hacker-fab/usb-pd-psu/README.md

# USB PD PSU
Inspired by the [PocketPD project](https://github.com/CentyLab/PocketPD).  
Adjustable DC power supply based on AVS/PPS USB PD protocols. 
Uses the TPS26750A USB PD controller to handle up to 240W.
