hacker-fab/usb-pd-psu/hardware/pd_psu.pdf

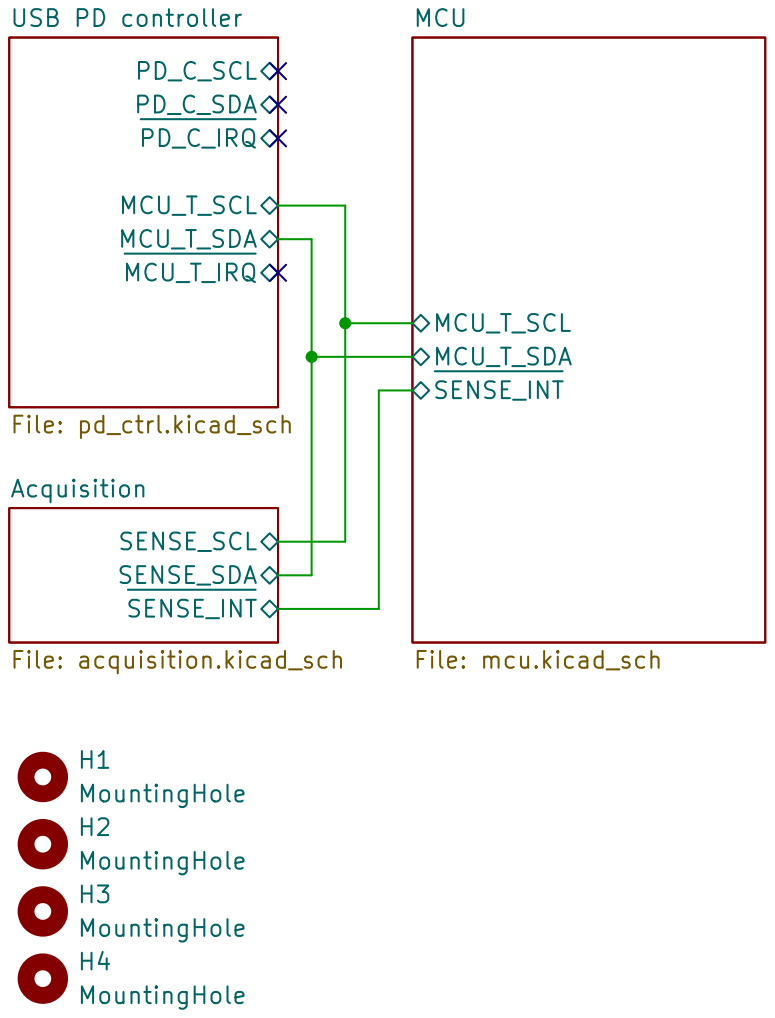
[picture p1: page 1]

Size: A4 | Rev:
KiCad E.D.A. 10.0.8 | Id: 1/4

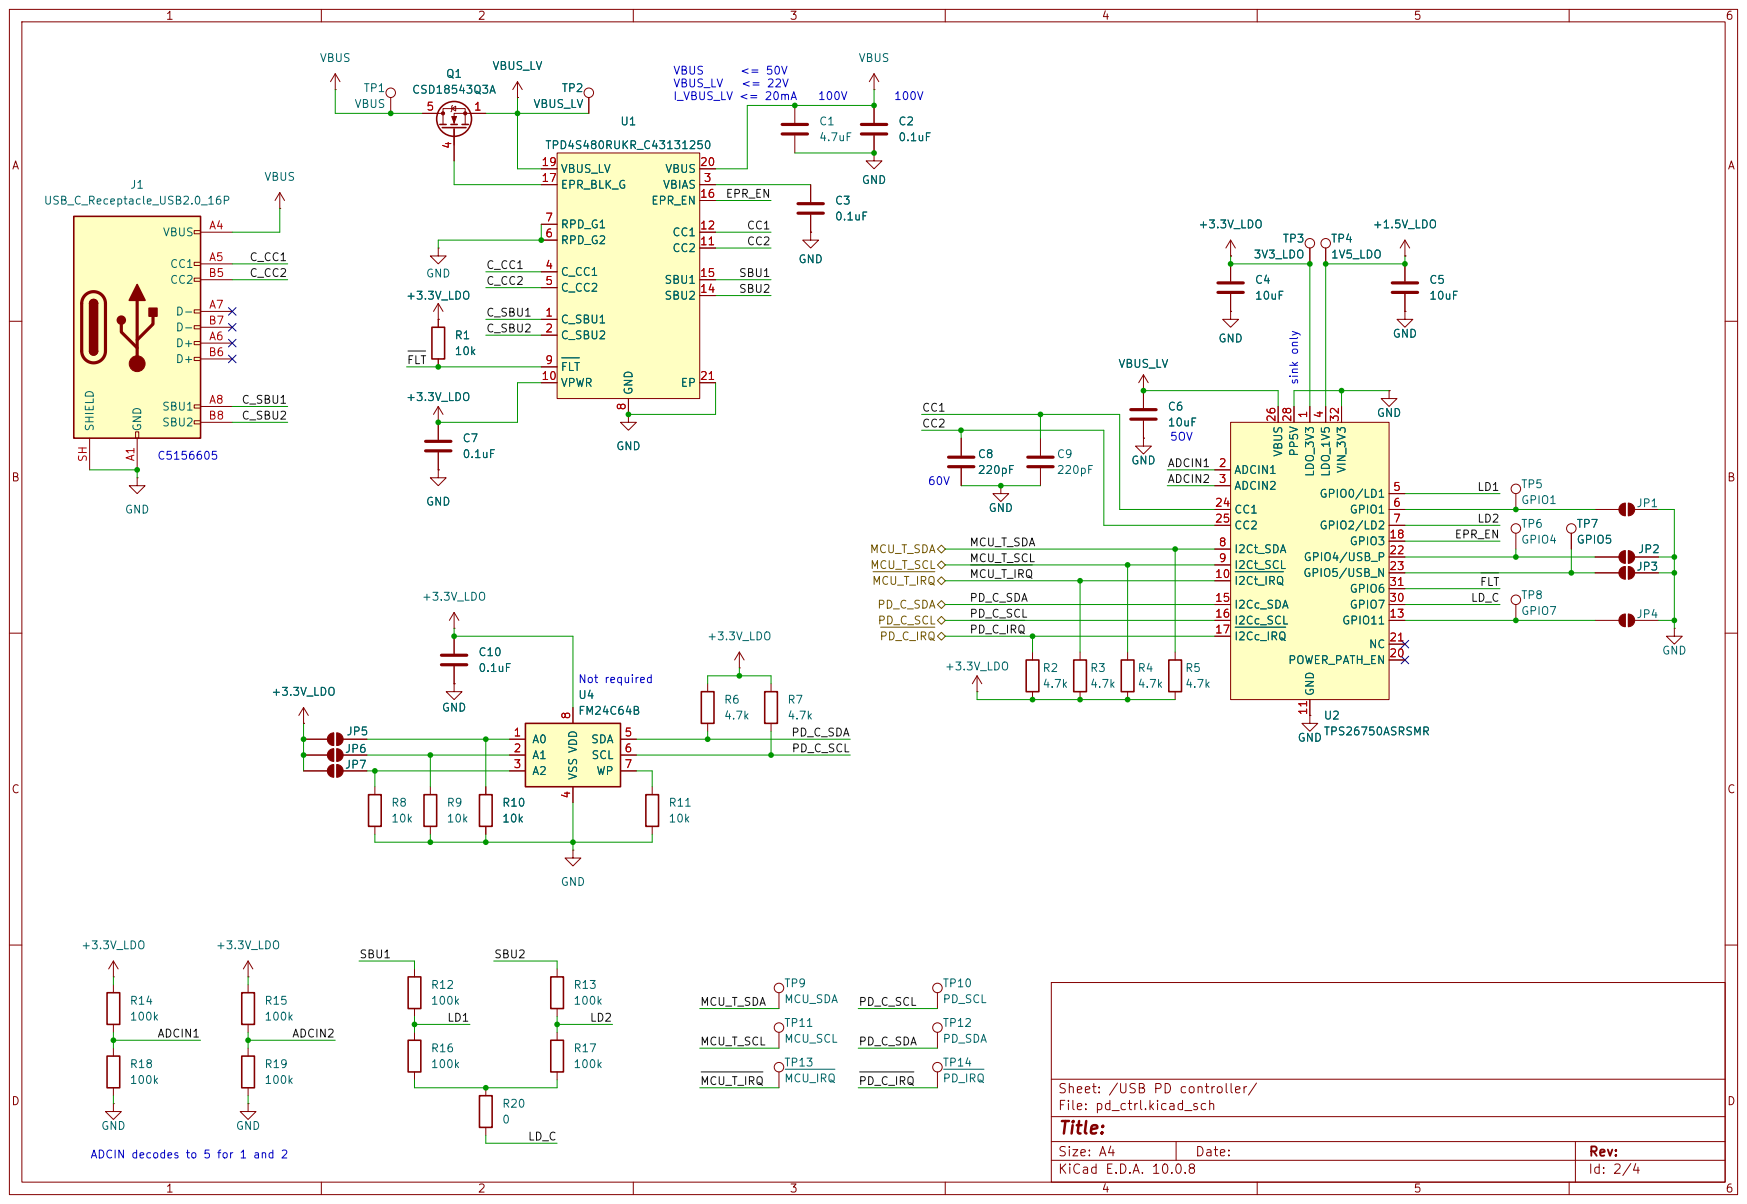
[picture p2: page 2]

I2Ct_SCL 9

Sheet: /USB PD controller/
File: pd_ctrl.kicad_sch
Title:

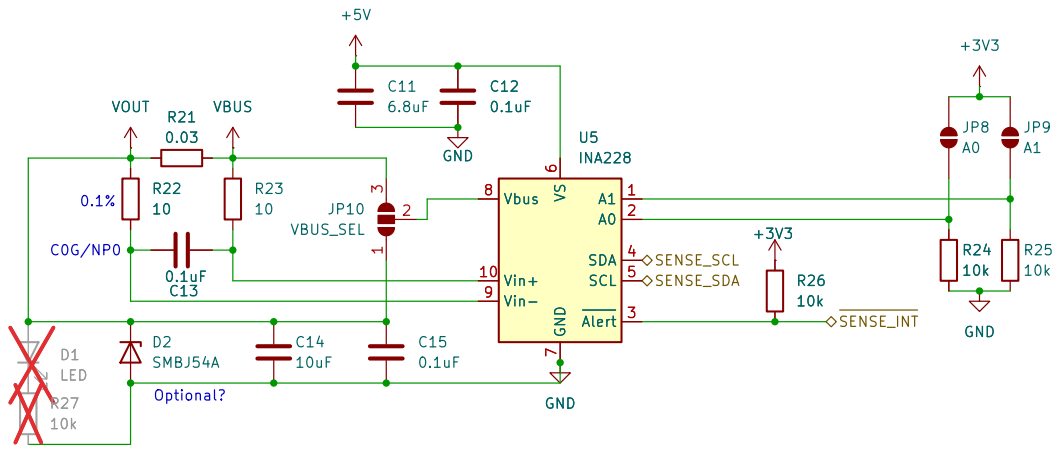
[picture p3: page 3]

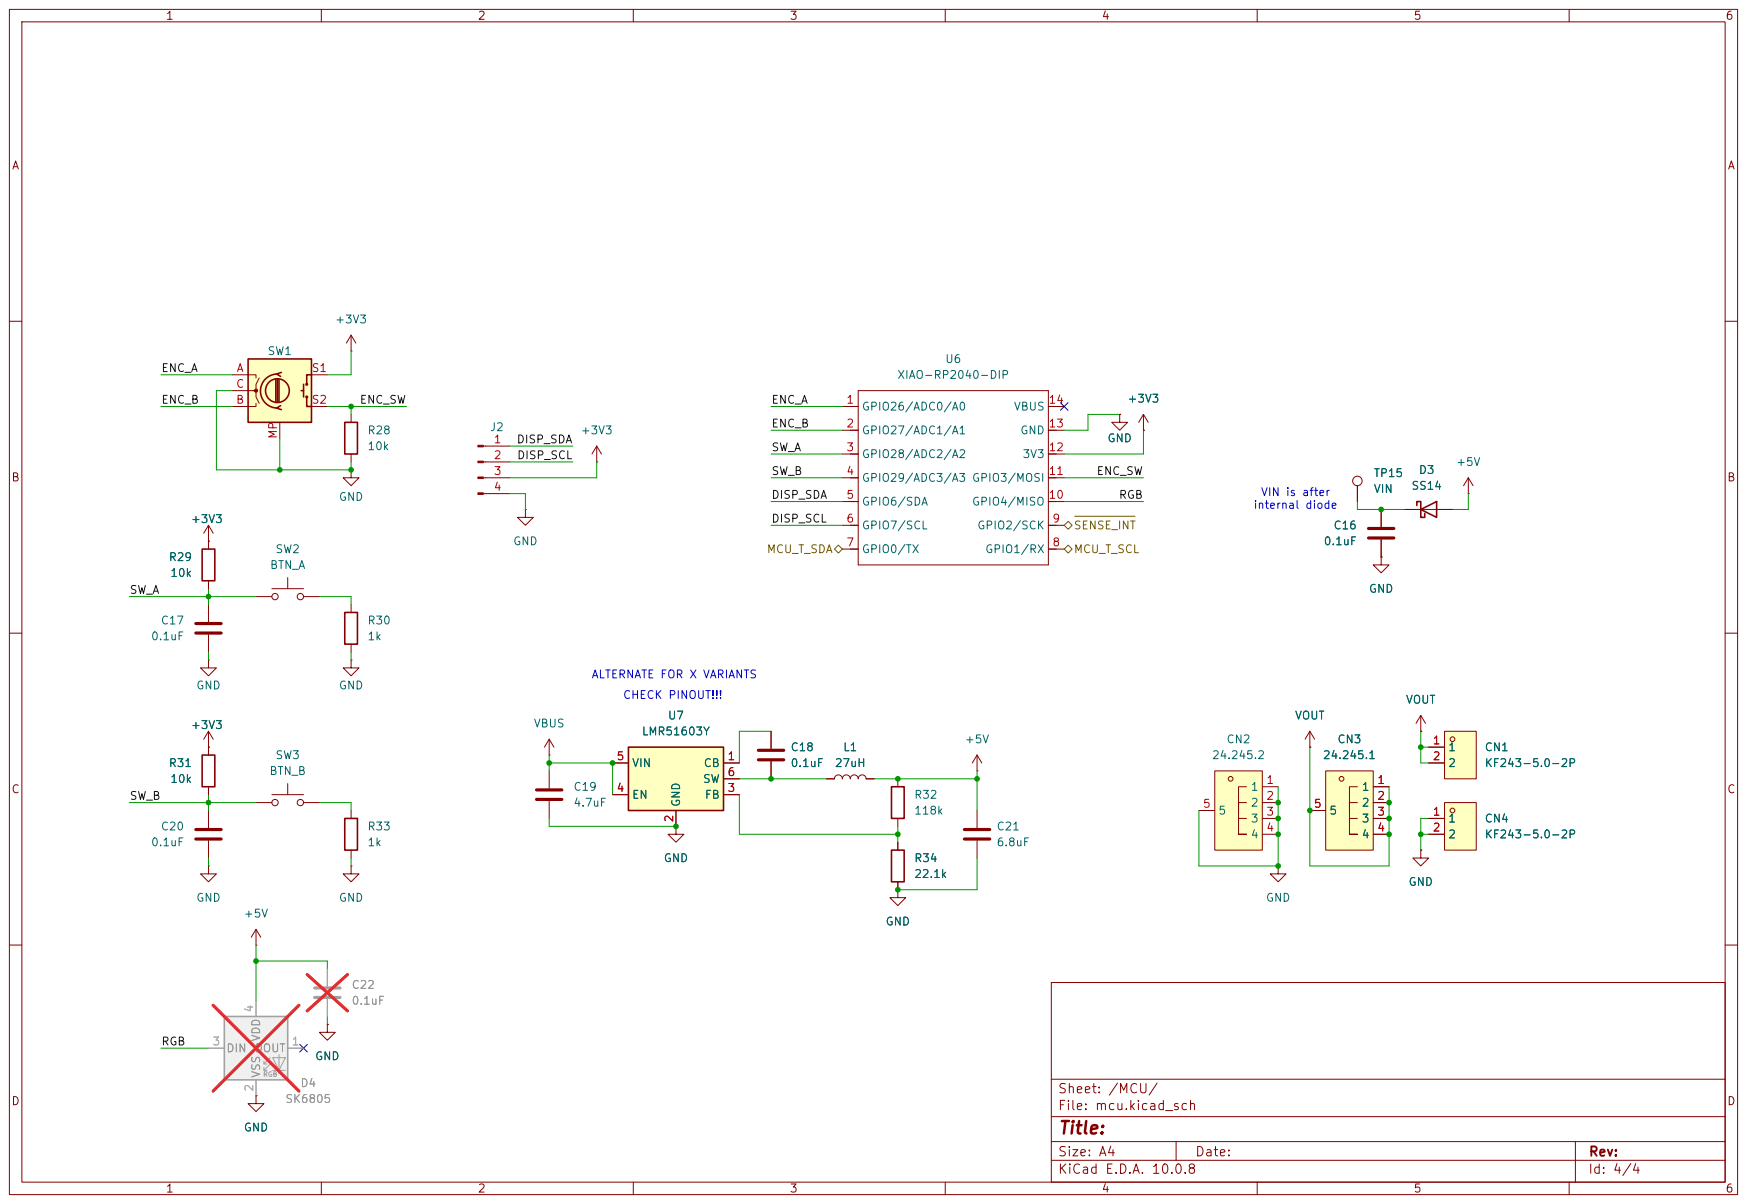
[picture p4: page 4]
