hacker-fab/usb-pd-psu/hardware/pd_psu.kicad_pcb

## KiCad design hardware/pd_psu.kicad_pcb (2026-11-10)

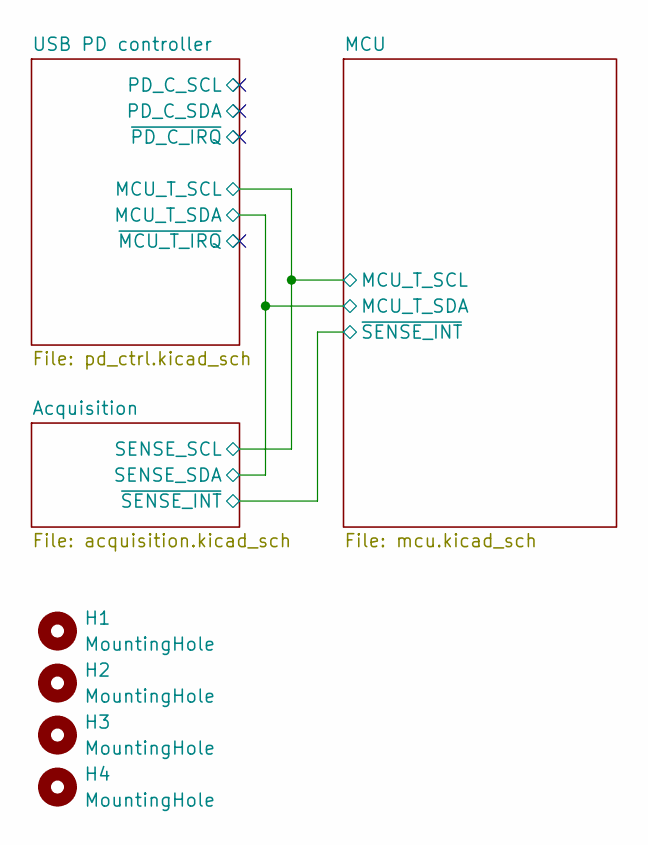
[picture p5: schematic pd_psu.kicad_sch]

Parts:
H1, H2, H3, H4: MountingHole; MountingHole_2.7mm_M2.5

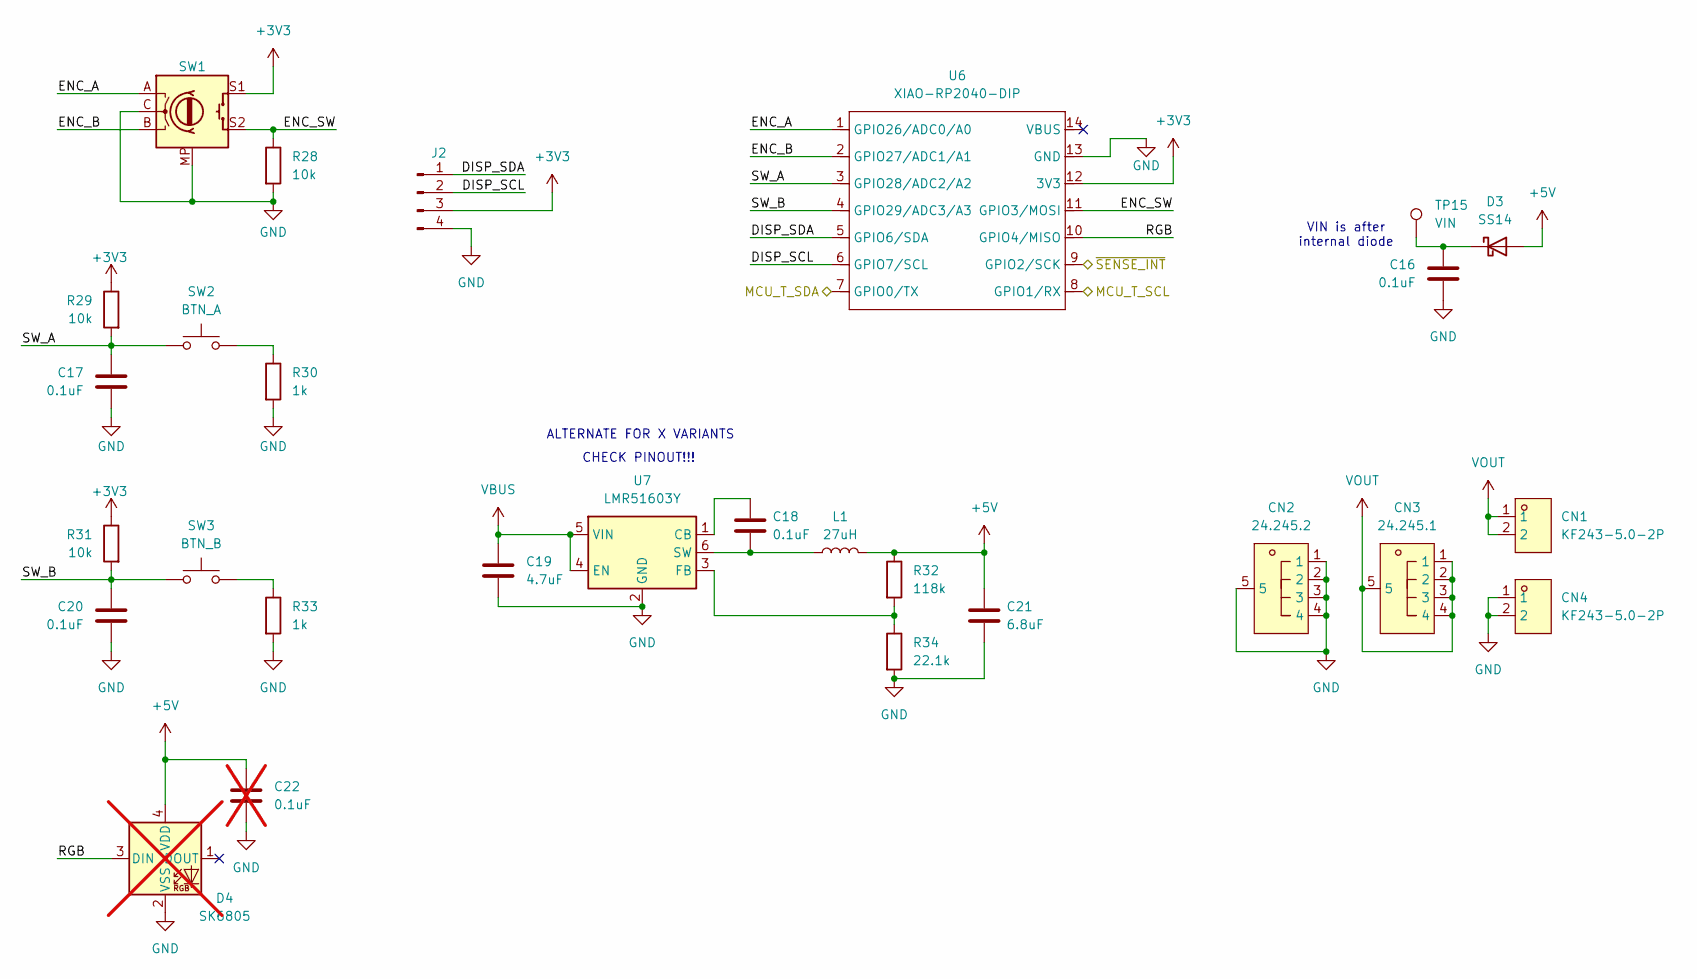
[picture p6: schematic mcu.kicad_sch]

Parts:
C16, C17, C20: 0.1uF; C_0603_1608Metric; LCSC ANY 16V
C18: 0.1uF; C_1206_3216Metric; LCSC C1945
C19: 4.7uF; C_1210_3225Metric; rating 100v; LCSC C381466
C21: 6.8uF; C_0603_1608Metric; LCSC C338096
C22: 0.1uF; C_0603_1608Metric; LCSC ANY 16V; not fitted
CN1, CN4: KF243-5.0-2P; CONN-TH_P5.00_KF243-5.0-2P; MPN KF243-5.0-2P; LCSC Part C475222
CN2: 24.245.2; ANT-TH_L33.0-W12.0_RED; MPN 24.245.2; LCSC Part C7437327
CN3: 24.245.1; ANT-TH_L33.0-W12.0_RED; MPN 24.245.1; LCSC Part C7437326
D3: SS14; D_SMA
D4: SK6805; LED_SK6805_PLCC4_2.4x2.7mm_P1.3mm; not fitted
J2: Conn_01x04_Pin; PinHeader_1x04_P2.54mm_Vertical
L1: 27uH; IND-SMD_L4.7-W4.7; LCSC C2983066 OR C187286
R28, R29, R31: 10k; R_0603_1608Metric
R30, R33: 1k; R_0603_1608Metric
R32: 118k; R_0603_1608Metric; LCSC C5126230
R34: 22.1k; R_0603_1608Metric; LCSC C2960862
SW1: RotaryEncoder_Switch_MP; RotaryEncoder_EC11B-Horizontal-Dual; LCSC C470710
SW2: BTN_A; SW-SMD_L6.0-W6.0-LS6.6; LCSC C398058
SW3: BTN_B; SW-SMD_L6.0-W6.0-LS6.6; LCSC C398058
TP15: VIN; TestPoint_Pad_D1.5mm
U6: XIAO-RP2040-DIP
U7: LMR51603Y; SOT-23-6; LCSC C43351621

Connections:
+3V3: J2.3, R29.1, R31.1, SW1.S1, U6.12 (3V3); also elsewhere on the board
+5V: C21.1, C22.1, D3.2 (A), D4.4 (VDD), L1.2, R32.1; also elsewhere on the board
/Acquisition/~SENSE_INT: U6.9 (GPIO2/SCK); also elsewhere on the board
/MCU/DISP_SCL: J2.2, U6.6 (GPIO7/SCL)
/MCU/DISP_SDA: J2.1, U6.5 (GPIO6/SDA)
/MCU/ENC_A: SW1.A, U6.1 (GPIO26/ADC0/A0)
/MCU/ENC_B: SW1.B, U6.2 (GPIO27/ADC1/A1)
/MCU/ENC_SW: R28.1, SW1.S2, U6.11 (GPIO3/MOSI)
/MCU/RGB: D4.3 (DIN), U6.10 (GPIO4/MISO)
/MCU/SW_A: C17.1, R29.2, SW2.1, U6.3 (GPIO28/ADC2/A2)
/MCU/SW_B: C20.1, R31.2, SW3.1, U6.4 (GPIO29/ADC3/A3)
/USB PD controller/MCU_T_SCL: U6.8 (GPIO1/RX); also elsewhere on the board
/USB PD controller/MCU_T_SDA: U6.7 (GPIO0/TX); also elsewhere on the board
GND: C16.2, C17.2, C19.2, C20.2, C21.2, C22.2, CN2.1, CN2.2, CN2.3, CN2.4, CN2.5, CN4.1, CN4.2, D4.2 (VSS), J2.4, R28.2, R30.2, R33.2, R34.2, SW1.C, SW1.MP, U6.13 (GND), U7.2 (GND); also elsewhere on the board
unnamed: C16.1, D3.1 (K), TP15.1 (1_1)
unnamed: R30.1, SW2.2
unnamed: R33.1, SW3.2
unnamed: C18.1, U7.1 (CB)
unnamed: R32.2, R34.1, U7.3 (FB)
unnamed: C18.2, L1.1, U7.6 (SW)
VBUS: C19.1, U7.4 (EN), U7.5 (VIN); also elsewhere on the board
VOUT: CN1.1, CN1.2, CN3.1, CN3.2, CN3.3, CN3.4, CN3.5; also elsewhere on the board

Notes on the sheet:
CHECK PINOUT!!!
ALTERNATE FOR X VARIANTS
VIN is after internal diode

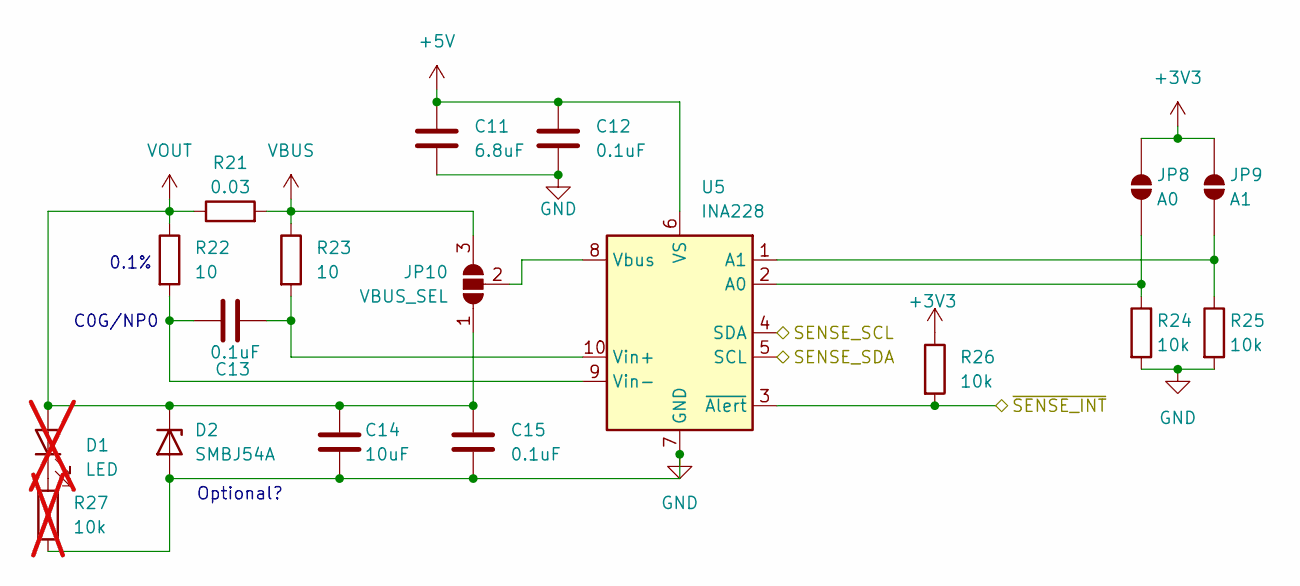
[picture p7: schematic acquisition.kicad_sch]

Parts:
C11: 6.8uF; C_0603_1608Metric; LCSC C338096
C12: 0.1uF; C_0603_1608Metric
C13: 0.1uF; C_1206_3216Metric; LCSC C1864297
C14: 10uF; C_1210_3225Metric
C15: 0.1uF; C_1206_3216Metric; rating 100V; LCSC C1945
D1: LED; LED_0603_1608Metric; not fitted
D2: SMBJ54A; D_SMB; LCSC C49066951
JP8: A0; SolderJumper-2_P1.3mm_Open_TrianglePad1.0x1.5mm
JP9: A1; SolderJumper-2_P1.3mm_Open_TrianglePad1.0x1.5mm
JP10: VBUS_SEL; SolderJumper-3_P2.0mm_Open_TrianglePad1.0x1.5mm
R21: 0.03; R_2512_6332Metric; LCSC C22468062
R22, R23: 10; R_0603_1608Metric; LCSC C861082
R24, R25, R26: 10k; R_0603_1608Metric
R27: 10k; R_0603_1608Metric; not fitted
U5: INA228; TSSOP-10_3x3mm_P0.5mm

Connections:
+3V3: JP8.1 (A), JP9.1 (A), R26.1; also elsewhere on the board
+5V: C11.1, C12.1, U5.6 (VS); also elsewhere on the board
/Acquisition/~SENSE_INT: R26.2, U5.3 (~Alert); also elsewhere on the board
/USB PD controller/MCU_T_SCL: U5.4 (SDA); also elsewhere on the board
/USB PD controller/MCU_T_SDA: U5.5 (SCL); also elsewhere on the board
GND: C11.2, C12.2, C14.2, C15.2, D2.2 (A), R24.2, R25.2, R27.2, U5.7 (GND); also elsewhere on the board
unnamed: D1.1 (K), R27.1
unnamed: JP8.2 (B), R24.1, U5.2 (A0)
unnamed: JP9.2 (B), R25.1, U5.1 (A1)
unnamed: JP10.2 (C), U5.8 (Vbus)
unnamed: C13.2, R23.2, U5.10 (Vin+)
unnamed: C13.1, R22.2, U5.9 (Vin-)
VBUS: JP10.3 (B), R21.2, R23.1; also elsewhere on the board
VOUT: C14.1, C15.1, D1.2 (A), D2.1 (K), JP10.1 (A), R21.1, R22.1; also elsewhere on the board

Notes on the sheet:
C0G/NP0
Optional?
0.1%

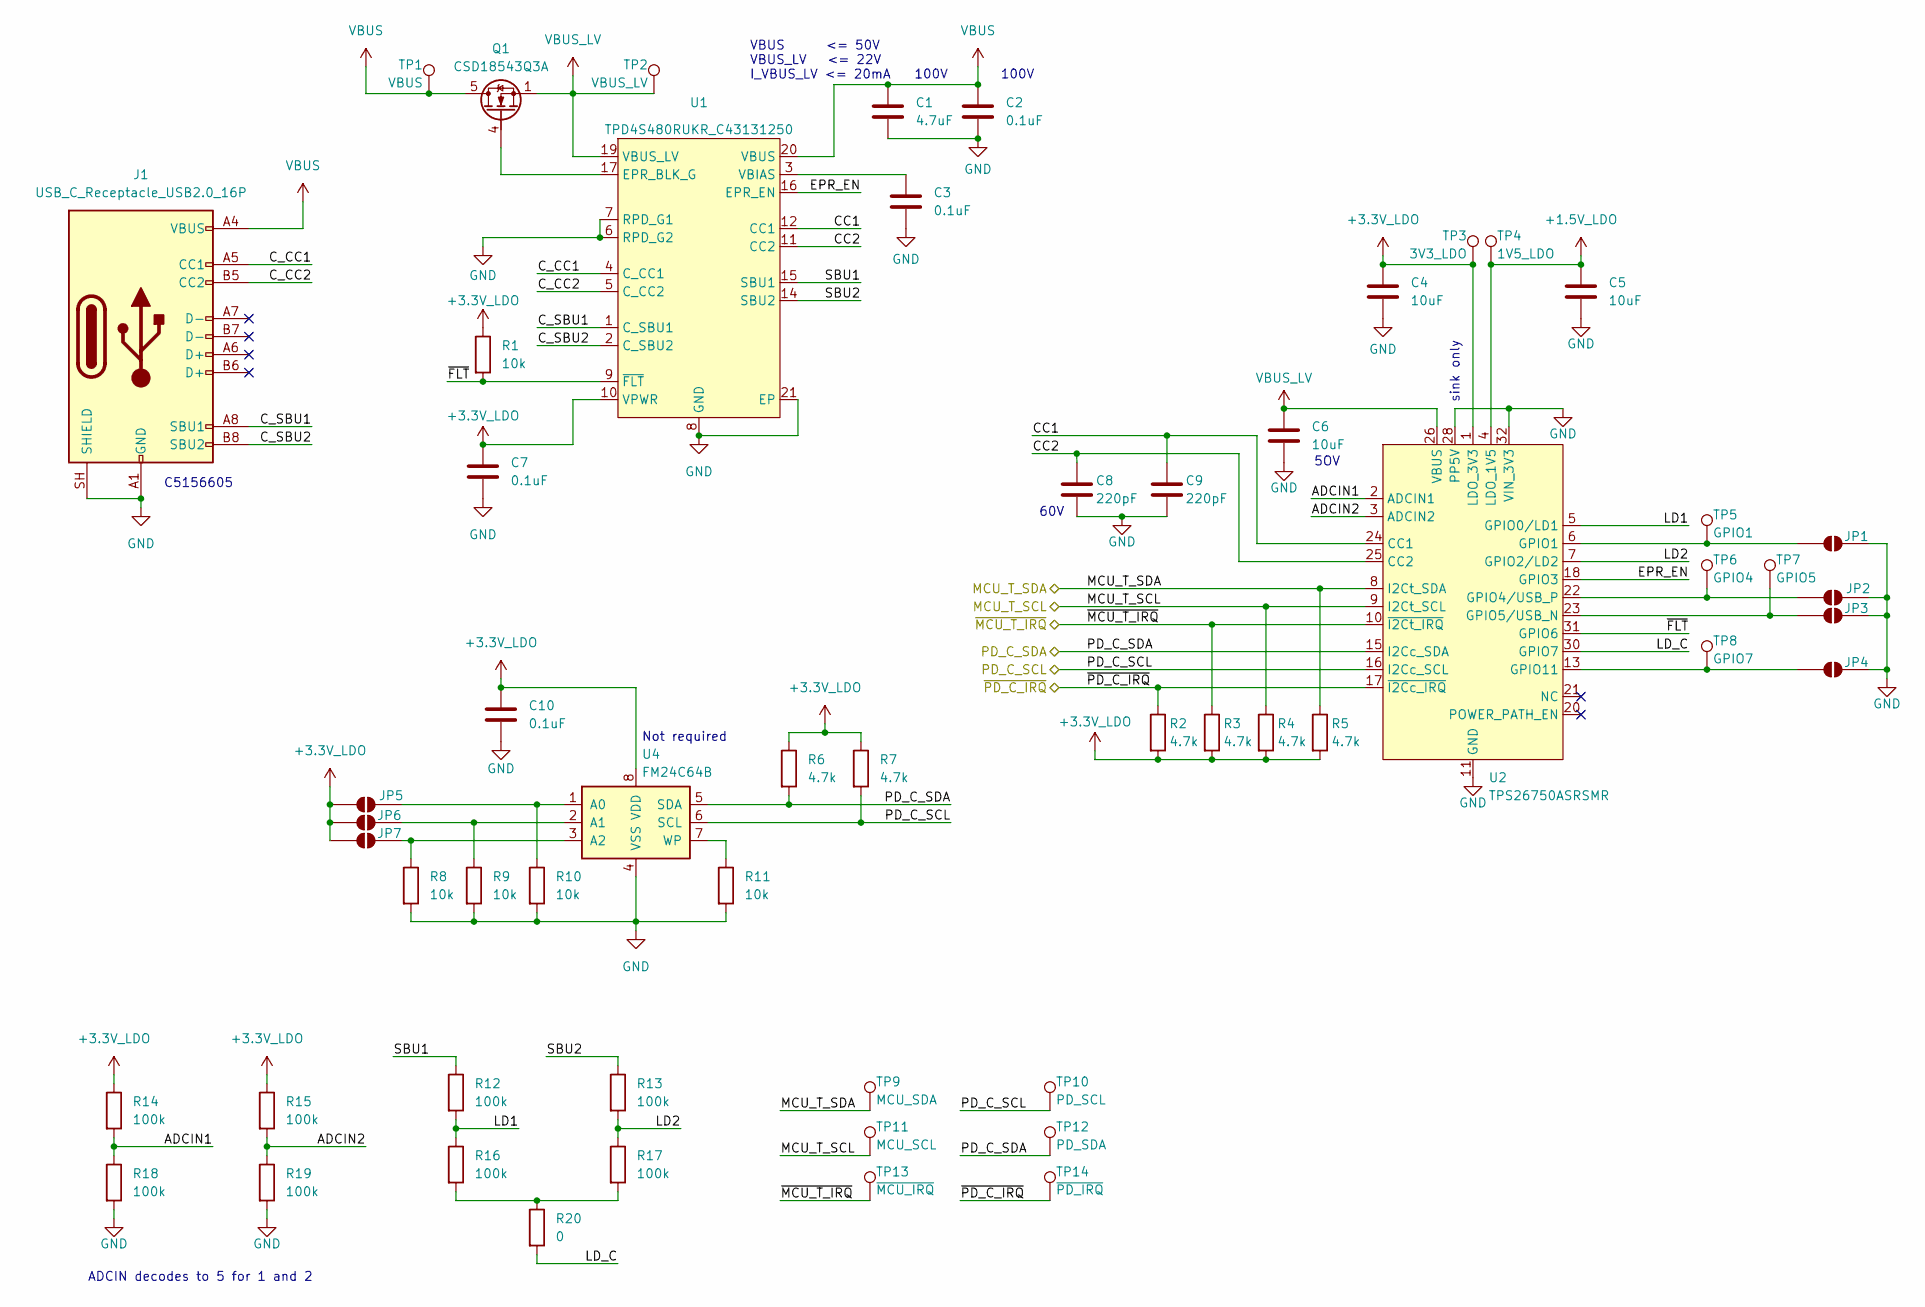
[picture p8: schematic pd_ctrl.kicad_sch]

Parts:
C1: 4.7uF; C_1210_3225Metric; rating 100v; LCSC C381466
C2: 0.1uF; C_1206_3216Metric; rating 100V; LCSC C1945
C3: 0.1uF; C_1206_3216Metric; LCSC C1945
C4, C5: 10uF; C_0805_2012Metric; LCSC C15850
C6: 10uF; C_0805_2012Metric; LCSC C22367830
C7, C10: 0.1uF; C_0603_1608Metric; LCSC ANY 16V
C8, C9: 220pF; C_0603_1608Metric; LCSC C106210
J1: USB_C_Receptacle_USB2.0_16P; TYPE-C-USB-SMD_QCHT-143
JP1, JP2, JP3, JP4, JP5, JP6, JP7: SolderJumper_2_Open; SolderJumper-2_P1.3mm_Open_TrianglePad1.0x1.5mm
Q1: CSD18543Q3A; VSON-8_3.3x3.3mm_P0.65mm_NexFET; LCSC C840100
R1, R8, R9, R10, R11: 10k; R_0603_1608Metric
R2, R3, R4, R5, R6, R7: 4.7k; R_0603_1608Metric
R12, R13, R14, R15, R16, R17, R18, R19: 100k; R_0603_1608Metric
R20: 0; R_0603_1608Metric
TP1: VBUS; TestPoint_Pad_D1.5mm
TP2: VBUS_LV; TestPoint_Pad_D1.5mm
TP3: 3V3_LDO; TestPoint_Pad_D1.5mm
TP4: 1V5_LDO; TestPoint_Pad_D1.5mm
TP5: GPIO1; TestPoint_Pad_D1.5mm
TP6: GPIO4; TestPoint_Pad_D1.5mm
TP7: GPIO5; TestPoint_Pad_D1.5mm
TP8: GPIO7; TestPoint_Pad_D1.5mm
TP9: MCU_SDA; TestPoint_Pad_D1.5mm
TP10: PD_SCL; TestPoint_Pad_D1.5mm
TP11: MCU_SCL; TestPoint_Pad_D1.5mm
TP12: PD_SDA; TestPoint_Pad_D1.5mm
TP13: ~{MCU_IRQ}; TestPoint_Pad_D1.5mm
TP14: ~{PD_IRQ}; TestPoint_Pad_D1.5mm
U1: TPD4S480RUKR_C43131250; WQFN-20_L3.0-W3.0-P0.40-BL-EP1.7; MPN TPD4S480RUKR; LCSC Part C43131250
U2: TPS26750ASRSMR; QFN-32_L4.0-W4.0-P0.40-BL-EP2.8; MPN TPS26750SRSMR; LCSC Part C42166327
U4: FM24C64B; SOIC-8_3.9x4.9mm_P1.27mm; LCSC C79988

Connections:
+1.5V_LDO: C5.1, TP4.1, U2.4 (LDO_1V5); also elsewhere on the board
+3.3V_LDO: C4.1, C7.1, C10.1, JP5.1 (A), JP6.1 (A), JP7.1 (A), R1.1, R2.2, R3.2, R4.2, R5.2, R6.1, R7.1, R14.1, R15.1, TP3.1, U1.10 (VPWR), U2.1 (LDO_3V3), U4.8 (VDD); also elsewhere on the board
/USB PD controller/ADCIN1: R14.2, R18.1, U2.2 (ADCIN1)
/USB PD controller/ADCIN2: R15.2, R19.1, U2.3 (ADCIN2)
/USB PD controller/CC1: C9.1, U1.12 (CC1), U2.24 (CC1)
/USB PD controller/CC2: C8.1, U1.11 (CC2), U2.25 (CC2)
/USB PD controller/C_CC1: J1.A5 (CC1), U1.4 (C_CC1)
/USB PD controller/C_CC2: J1.B5 (CC2), U1.5 (C_CC2)
/USB PD controller/C_SBU1: J1.A8 (SBU1), U1.1 (C_SBU1)
/USB PD controller/C_SBU2: J1.B8 (SBU2), U1.2 (C_SBU2)
/USB PD controller/D_+: J1.A6 (D+), J1.B6 (D+)
/USB PD controller/D_-: J1.A7 (D-), J1.B7 (D-)
/USB PD controller/EPR_EN: U1.16 (EPR_EN), U2.18 (GPIO3)
/USB PD controller/LD1: R12.2, R16.1, U2.5 (GPIO0/LD1)
/USB PD controller/LD2: R13.2, R17.1, U2.7 (GPIO2/LD2)
/USB PD controller/LD_C: R20.2, U2.30 (GPIO7)
/USB PD controller/MCU_T_SCL: R4.1, TP11.1, U2.9 (I2Ct_SCL); also elsewhere on the board
/USB PD controller/MCU_T_SDA: R5.1, TP9.1, U2.8 (I2Ct_SDA); also elsewhere on the board
/USB PD controller/PD_C_SCL: R7.2, TP10.1, U2.16 (I2Cc_SCL), U4.6 (SCL); also elsewhere on the board
/USB PD controller/PD_C_SDA: R6.2, TP12.1, U2.15 (I2Cc_SDA), U4.5 (SDA); also elsewhere on the board
/USB PD controller/SBU1: R12.1, U1.15 (SBU1)
/USB PD controller/SBU2: R13.1, U1.14 (SBU2)
/USB PD controller/~FLT: R1.2, U1.9 (~FLT), U2.31 (GPIO6)
/USB PD controller/~MCU_T_IRQ: R3.1, TP13.1, U2.10 (~I2Ct_IRQ)
/USB PD controller/~PD_C_IRQ: R2.1, TP14.1, U2.17 (~I2Cc_IRQ)
GND: C1.2, C2.2, C3.2, C4.2, C5.2, C6.2, C7.2, C8.2, C9.2, C10.2, J1.A1 (GND), J1.A12 (GND), J1.B1 (GND), J1.B12 (GND), J1.SH (SHIELD), JP1.2 (B), JP2.2 (B), JP3.2 (B), JP4.2 (B), R8.2, R9.2, R10.2, R11.2, R18.2, R19.2, U1.6 (RPD_G2), U1.7 (RPD_G1), U1.8 (GND), U1.13 (GND), U1.18 (GND), U1.21 (EP), U2.11 (GND), U2.12 (GND), U2.14 (GND), U2.19 (GND), U2.28 (PP5V), U2.29 (PP5V), U2.32 (VIN_3V3), U2.33 (GND), U4.4 (VSS); also elsewhere on the board
unnamed: JP1.1 (A), TP5.1 (1_1), U2.6 (GPIO1)
unnamed: JP2.1 (A), TP6.1 (1_1), U2.22 (GPIO4/USB_P)
unnamed: JP3.1 (A), TP7.1 (1_1), U2.23 (GPIO5/USB_N)
unnamed: JP4.1 (A), TP8.1 (1_1), U2.13 (GPIO11)
unnamed: JP5.2 (B), R10.1, U4.1 (A0)
unnamed: JP6.2 (B), R9.1, U4.2 (A1)
unnamed: JP7.2 (B), R8.1, U4.3 (A2)
unnamed: Q1.4 (G), U1.17 (EPR_BLK_G)
unnamed: R16.2, R17.2, R20.1
unnamed: C3.1, U1.3 (VBIAS)
unnamed: R11.1, U4.7 (WP)
VBUS: C1.1, C2.1, J1.A4 (VBUS), J1.A9 (VBUS), J1.B4 (VBUS), J1.B9 (VBUS), Q1.5 (D), TP1.1, U1.20 (VBUS); also elsewhere on the board
VBUS_LV: C6.1, Q1.1 (S), Q1.2 (S), Q1.3 (S), TP2.1, U1.19 (VBUS_LV), U2.26 (VBUS), U2.27 (VBUS); also elsewhere on the board

Notes on the sheet:
C5156605
100V
sink only
5OV
ADCIN decodes to 5 for 1 and 2
VBUS <= 50V VBUS_LV <= 22V I_VBUS_LV <= 20mA
60V
Not required

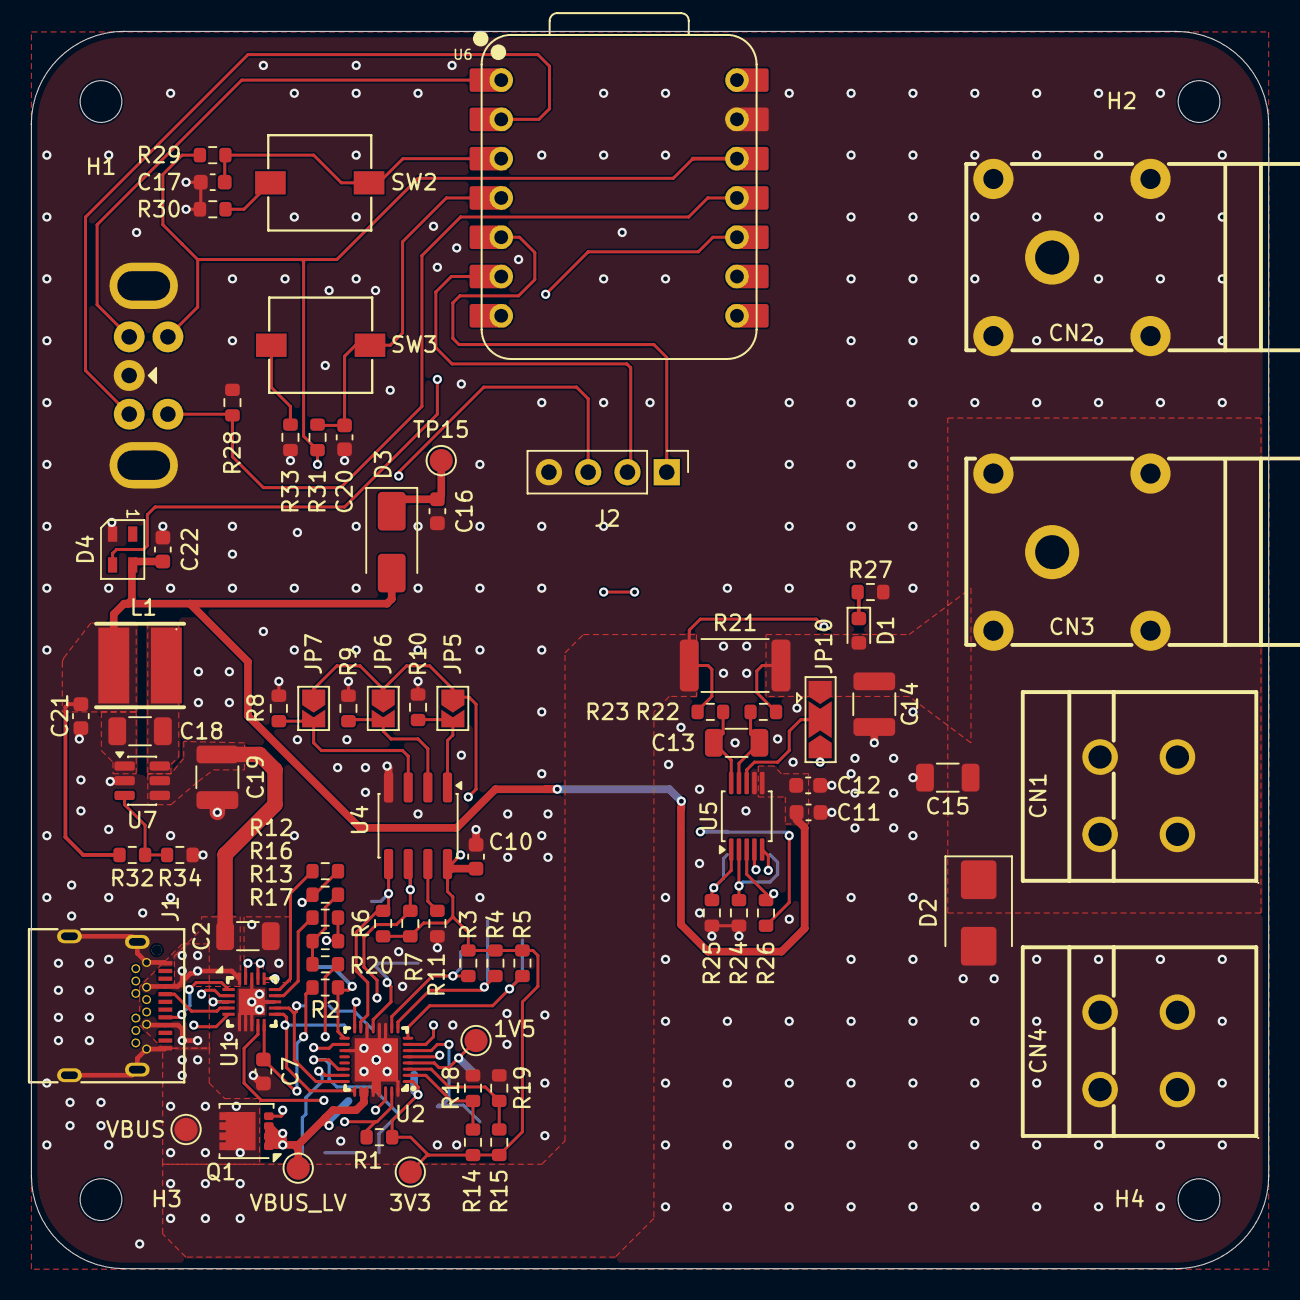
[picture p9: board pd_psu.kicad_pcb from above]

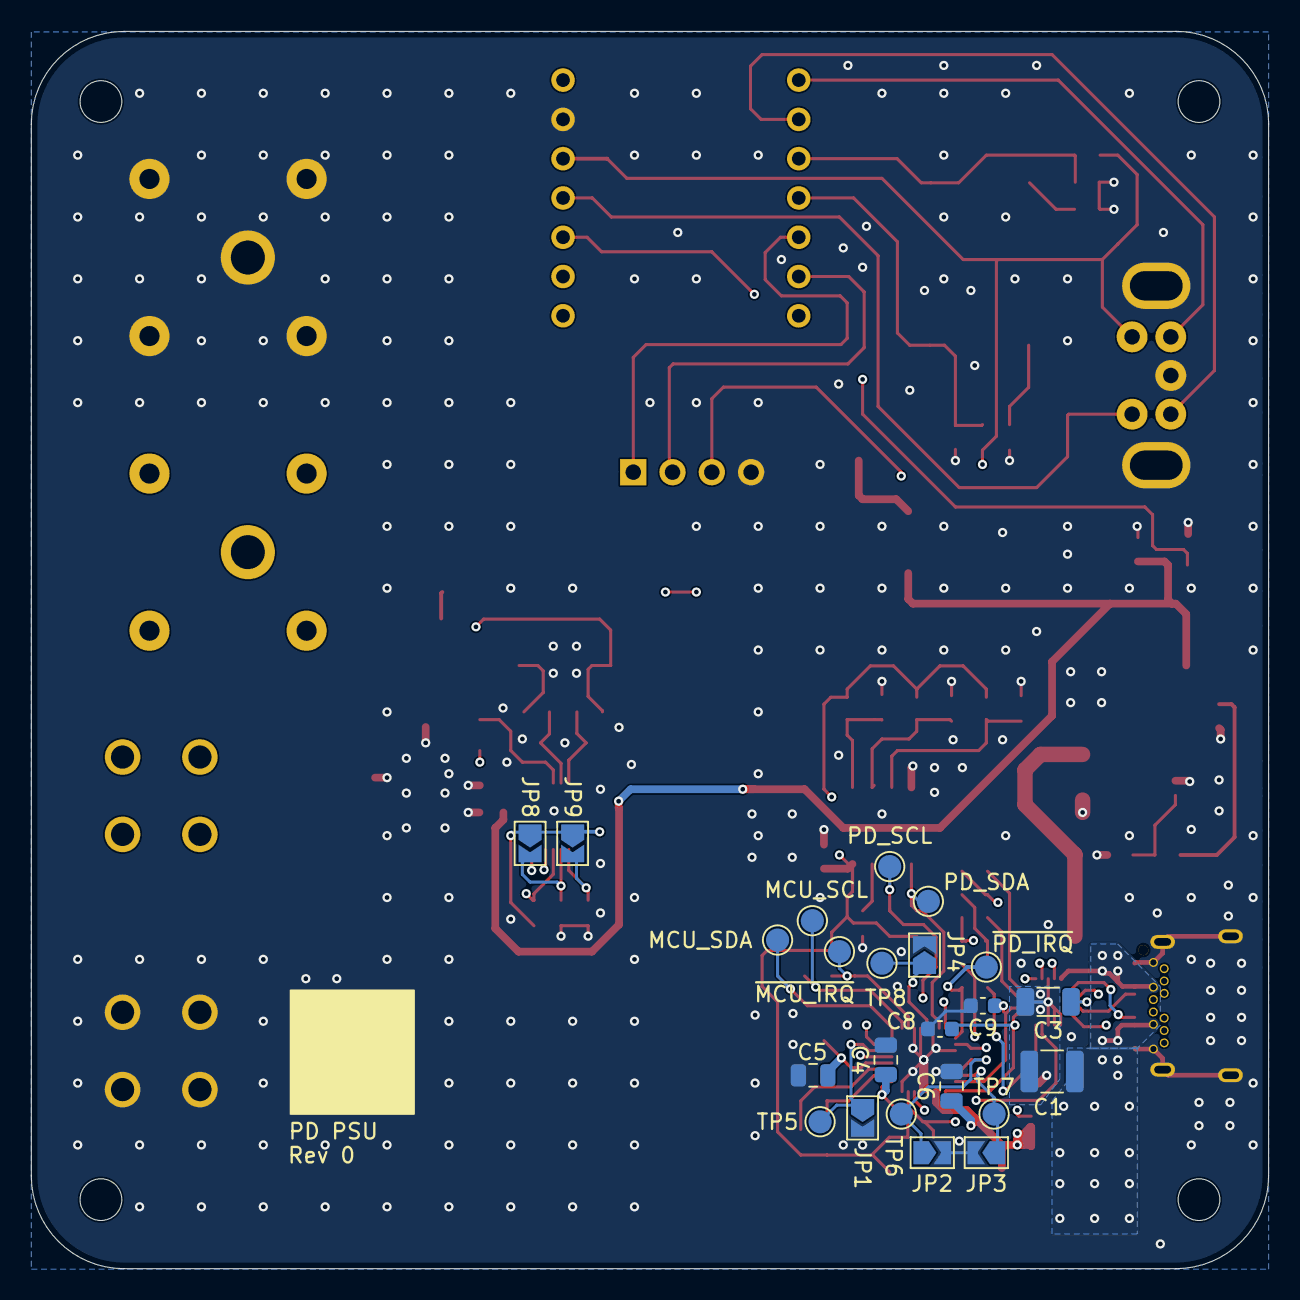
[picture p10: board pd_psu.kicad_pcb from below]

Board: 4 copper layers, 80.0 x 80.0 mm, 104 parts (21 on the bottom side), 63 nets.

Other parts of the board:
1V5: 1V5_LDO; TestPoint_Pad_D1.5mm
3V3: 3V3_LDO; TestPoint_Pad_D1.5mm
MCU_SCL: MCU_SCL; TestPoint_Pad_D1.5mm
MCU_SDA: MCU_SDA; TestPoint_Pad_D1.5mm
PD_SCL: PD_SCL; TestPoint_Pad_D1.5mm
PD_SDA: PD_SDA; TestPoint_Pad_D1.5mm
VBUS: VBUS; TestPoint_Pad_D1.5mm
VBUS_LV: VBUS_LV; TestPoint_Pad_D1.5mm

Their connections:
+1.5V_LDO: 1V5.1 (1_1); also elsewhere on the board
+3.3V_LDO: 3V3.1 (1_1); also elsewhere on the board
/USB PD controller/MCU_T_SCL: MCU_SCL.1 (1_1); also elsewhere on the board
/USB PD controller/MCU_T_SDA: MCU_SDA.1 (1_1); also elsewhere on the board
/USB PD controller/PD_C_SCL: PD_SCL.1 (1_1); also elsewhere on the board
/USB PD controller/PD_C_SDA: PD_SDA.1 (1_1); also elsewhere on the board
VBUS: VBUS.1 (1_1); also elsewhere on the board
VBUS_LV: VBUS_LV.1 (1_1); also elsewhere on the board
